lawrancekiamilev/FourChannelDiodebasedTemperatureMonitor/README.md

# FourChannelDiodebasedTemperatureMonitor
this project is a pcb and programing project. it is designed to be able to read the temperature of any diode based on its non ideal diode factor.  It is also designed to read an i2c EEPROM for serial identification and incorporates itself with a gui
