lawrancekiamilev/FourChannelDiodebasedTemperatureMonitor/PCBFiles/jlcProduction/jlcPCBTempMonitor3.0BOM.xlsx

Comment | Designator | FootPrint | JLCPCB PART#
TAXM12M4RKDCDT2T | Y1 | Crystal:Crystal_SMD_3225-4Pin_3.2x2.5mm | C403945
ADS1115IDGS | U14, U17 | Package_SO:TSSOP-10_3x3mm_P0.5mm | C37593
OPA348AIDCKR | U13, U15 | LawranceUserLib:OPAx348 | C363280
REF3320AIDBZR | U9, U10 | Package_TO_SOT_SMD:SOT-23 | C527421
TMUX1309PWR | U6 | Package_SO:TSSOP-16_4.4x5mm_P0.65mm | C2866286
W25Q16JVSS | U5 | Package_SO:SOIC-8_5.3x5.3mm_P1.27mm | C131025
AZ1117IH-3.3TRG1 | U4 | LawranceUserLib:AZ11171 | C108495
RP2040 | U3 | Package_DFN_QFN:QFN-56-1EP_7x7mm_P0.4mm_EP3.2x3.2mm_ThermalVias | C2040
TCA9548APWR | U2 | LawranceUserLib:TCA9548A | C130026
75R | R58, R59 | Resistor_SMD:R_0603_1608Metric | C25133
0R | R55, R65 | Resistor_SMD:R_0603_1608Metric | C21189
51k | R32 | Resistor_SMD:R_0603_1608Metric | C351642
5.1k | R31 | Resistor_SMD:R_0603_1608Metric | C122969
200k | R26 | Resistor_SMD:R_0603_1608Metric | C728585
2M | R25 | Resistor_SMD:R_0805_2012Metric | C2984387
10k | R6,R7,R8,R11,R12,R13,R14,R15,R20,R21,R23,R24,R27,R30,R35,R36,R47,R48,R56,R57,R60,R61,R62,R84,R85 | Resistor_SMD:R_0603_1608Metric | C25804
330R | R5, R17, R28, R29, R33 | Resistor_SMD:R_0603_1608Metric | C22775
1k | R3, R9 | Resistor_SMD:R_0603_1608Metric | C21190
27R | R1, R4 | Resistor_SMD:R_0603_1608Metric | C25190
SZ2012K272TF | FB1 | Resistor_SMD:R_0805_2012Metric | C185876
CN | D2,D3,D4,D5 | LED_SMD:LED_0603_1608Metric_Pad1.05x0.95mm_HandSolder | C165981
3.3V | D1 | LED_SMD:LED_0603_1608Metric_Pad1.05x0.95mm_HandSolder | C19171390
100nf | C27, C29, C30, C32, C34, C35, C39, C41, C42 | Capacitor_SMD:C_0603_1608Metric | C14663
1uf | C26, C37 | Capacitor_SMD:C_0603_1608Metric | C15849
6.8uF | C13 | Capacitor_SMD:C_0805_2012Metric | C15850
10uF | C10 | Capacitor_SMD:C_0805_2012Metric | C5139488
100nF | C9,C14 | Capacitor_SMD:C_0805_2012Metric | C49678
100nF | C7,C8,C11,C12,C16,C24,C33,C36,C38,C40,C43,C45 | Capacitor_SMD:C_0603_1608Metric | C14663
2.2uF | C5 | Capacitor_SMD:C_0805_2012Metric | C19110
3.3uF | C4 | Capacitor_SMD:C_0805_2012Metric | C7393948
4.7uF | C3, C6 | Capacitor_SMD:C_0805_2012Metric | C1779
33pF | C1, C2 | Capacitor_SMD:C_0603_1608Metric | C107047
