lawrancekiamilev/FourChannelDiodebasedTemperatureMonitor/PCBFiles/TempMonitorRev3.0.kicad_pcb

## KiCad design PCBFiles/TempMonitorRev3.0.kicad_pcb (2025-09-04)

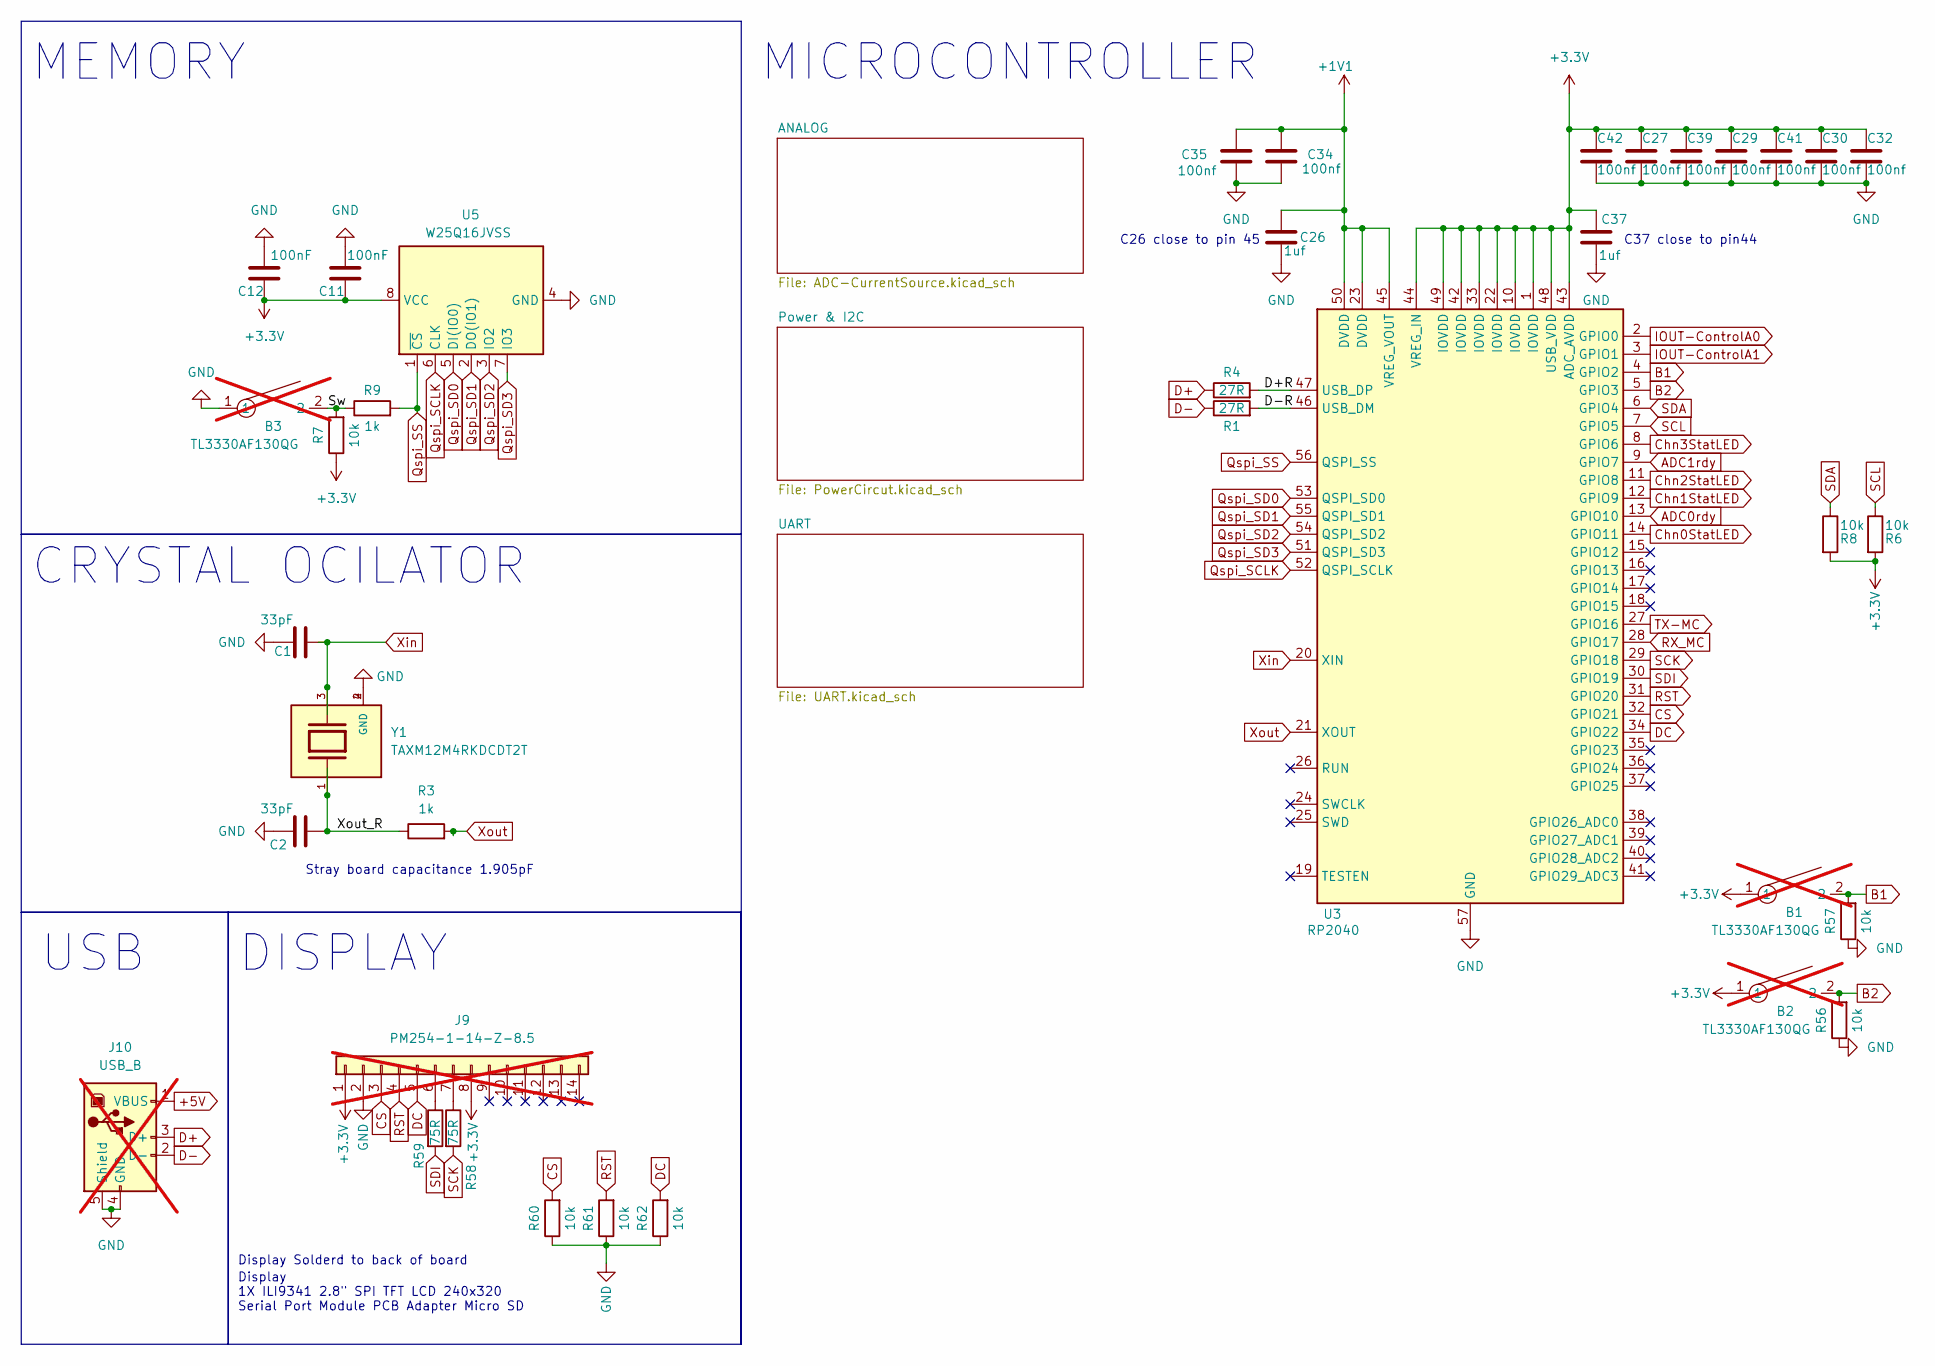
[picture p1: schematic TempMonitorRev3.0.kicad_sch, TempMonitorV3.0]

Parts:
B1, B2, B3: TL3330AF130QG; TL3330; JLC part # C2886885; not fitted
C1, C2: 33pF; C_0603_1608Metric; JLC part # C107047
C11, C12: 100nF; C_0603_1608Metric; JLC part # C14663
C26, C37: 1uf; C_0603_1608Metric; JLC part # C15849
C27, C29, C30, C32, C34, C35, C39, C41, C42: 100nf; C_0603_1608Metric; JLC part # C14663
J9: PM254-1-14-Z-8.5; PinSocket_1x14_P2.54mm_Vertical; JLC part # C2897377; not fitted
J10: USB_B; USB_B_OST_USB-B1HSxx_Horizontal; JLC part # C46392; not fitted
R1, R4: 27R; R_0603_1608Metric; JLC part # C25190
R3, R9: 1k; R_0603_1608Metric; JLC part # C21190
R6, R7, R8, R56, R57, R60, R61, R62: 10k; R_0603_1608Metric; JLC part # C25804
R58, R59: 75R; R_0603_1608Metric; JLC part # C25133
U3: RP2040; QFN-56-1EP_7x7mm_P0.4mm_EP3.2x3.2mm_ThermalVias; JLC part # C2040
U5: W25Q16JVSS; SOIC-8_5.3x5.3mm_P1.27mm; JLC part # C131025
Y1: TAXM12M4RKDCDT2T; Crystal_SMD_3225-4Pin_3.2x2.5mm; JLC part # C403945

Connections:
+1V1: C26.2, C34.1, C35.1, U3.23 (DVDD), U3.45 (VREG_VOUT), U3.50 (DVDD)
+3.3V: B1.1, B2.1, C11.1, C12.1, C27.1, C29.1, C30.1, C32.1, C37.2, C39.1, C41.1, C42.1, J9.1, J9.8, R6.2, R7.1, R8.2, U3.1 (IOVDD), U3.10 (IOVDD), U3.22 (IOVDD), U3.33 (IOVDD), U3.42 (IOVDD), U3.43 (ADC_AVDD), U3.44 (VREG_IN), U3.48 (USB_VDD), U3.49 (IOVDD), U5.8 (VCC); also elsewhere on the board
+5V: J10.1 (VBUS); also elsewhere on the board
/D+R: R4.2, U3.47 (USB_DP)
/D-R: R1.2, U3.46 (USB_DM)
/Sw: B3.2, R7.2, R9.1
/Xout_R: C2.1, R3.1, Y1.1
ADC0rdy: U3.13 (GPIO10); also elsewhere on the board
ADC1rdy: U3.9 (GPIO7); also elsewhere on the board
B1: B1.2, R57.2, U3.4 (GPIO2)
B2: B2.2, R56.2, U3.5 (GPIO3)
CS: J9.3, R60.2, U3.32 (GPIO21)
Chn0StatLED: U3.14 (GPIO11); also elsewhere on the board
Chn1StatLED: U3.12 (GPIO9); also elsewhere on the board
Chn2StatLED: U3.11 (GPIO8); also elsewhere on the board
Chn3StatLED: U3.8 (GPIO6); also elsewhere on the board
D+: J10.3 (D+), R4.1
D-: J10.2 (D-), R1.1
DC: J9.5, R62.2, U3.34 (GPIO22)
GND: B3.1, C1.2, C2.2, C11.2, C12.2, C26.1, C27.2, C29.2, C30.2, C32.2, C34.2, C35.2, C37.1, C39.2, C41.2, C42.2, J9.2, J10.4 (GND), J10.5 (Shield), R56.1, R57.1, R60.1, R61.1, R62.1, U3.57 (GND), U5.4 (GND), Y1.2 (GND), Y1.4 (GND); also elsewhere on the board
IOUT-ControlA0: U3.2 (GPIO0); also elsewhere on the board
IOUT-ControlA1: U3.3 (GPIO1); also elsewhere on the board
unnamed: J9.6, R59.1
unnamed: J9.7, R58.1
Qspi_SCLK: U3.52 (QSPI_SCLK), U5.6 (CLK)
Qspi_SD0: U3.53 (QSPI_SD0), U5.5 (DI(IO0))
Qspi_SD1: U3.55 (QSPI_SD1), U5.2 (DO(IO1))
Qspi_SD2: U3.54 (QSPI_SD2), U5.3 (IO2)
Qspi_SD3: U3.51 (QSPI_SD3), U5.7 (IO3)
Qspi_SS: R9.2, U3.56 (QSPI_SS), U5.1 (~CS)
RST: J9.4, R61.2, U3.31 (GPIO20)
RX_MC: U3.28 (GPIO17); also elsewhere on the board
SCK: R58.2, U3.29 (GPIO18)
SCL: R6.1, U3.7 (GPIO5); also elsewhere on the board
SDA: R8.1, U3.6 (GPIO4); also elsewhere on the board
SDI: R59.2, U3.30 (GPIO19)
TX-MC: U3.27 (GPIO16); also elsewhere on the board
Xin: C1.1, U3.20 (XIN), Y1.3
Xout: R3.2, U3.21 (XOUT)

Notes on the sheet:
C37 close to pin44
CRYSTAL OCILATOR
MICROCONTROLLER
Stray board capacitance 1.905pF
MEMORY
DISPLAY
Display 1X ILI9341 2.8" SPI TFT LCD 240x320 Serial Port Module PCB Adapter Micro SD
Display Solderd to back of board
USB
C26 close to pin 45

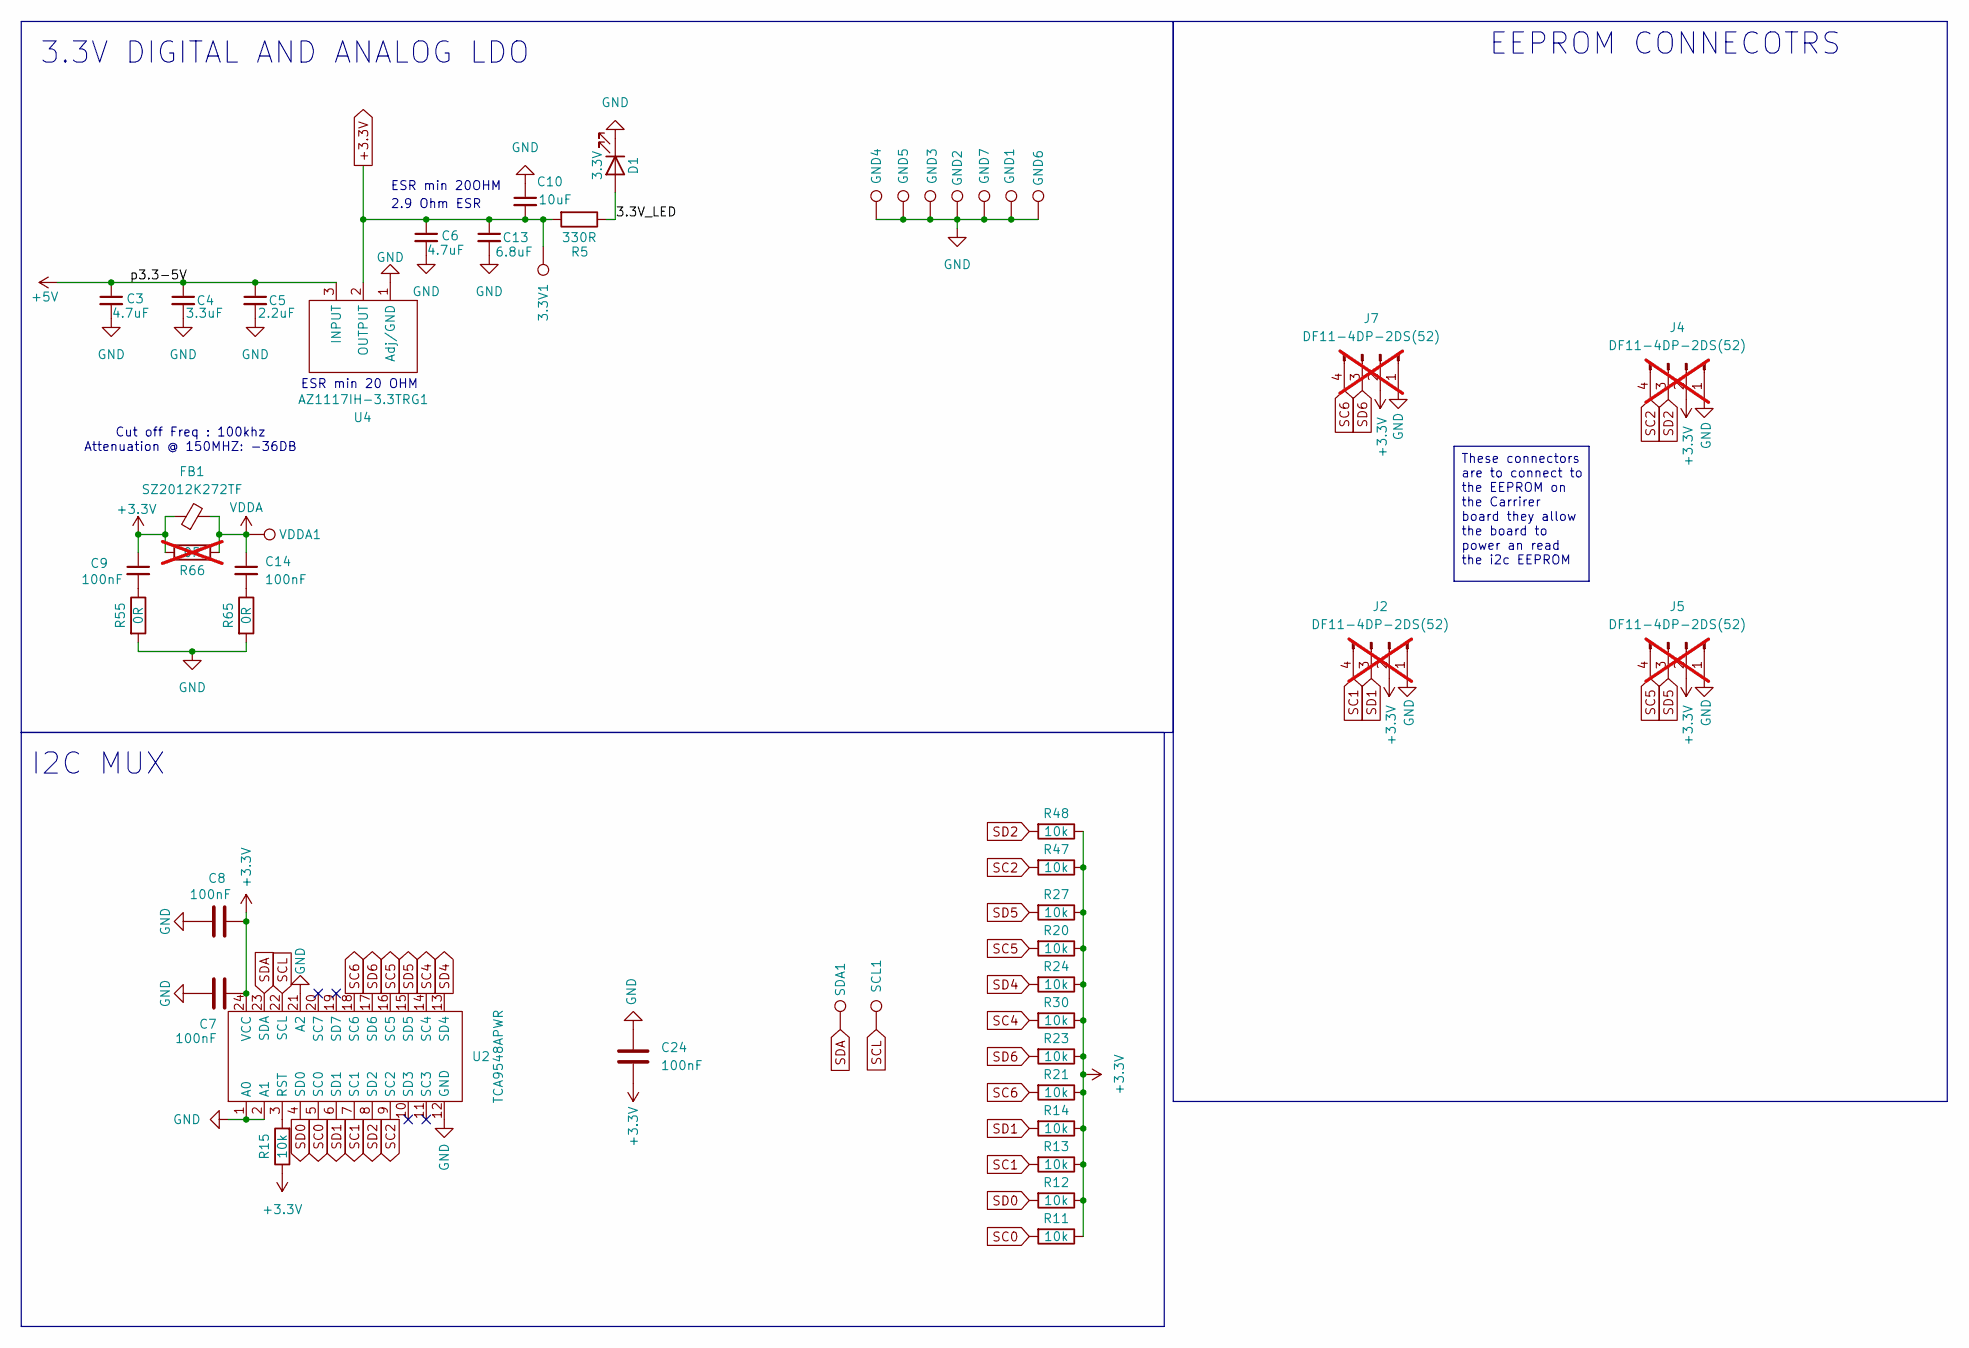
[picture p2: schematic PowerCircut.kicad_sch, TempMonitorV3.0]

Parts:
3.3V1: TestPoint; TestPoint_Pad_D1.5mm
C3, C6: 4.7uF; C_0805_2012Metric; JLC part # C1779
C4: 3.3uF; C_0805_2012Metric; JLC part # C7393948
C5: 2.2uF; C_0805_2012Metric; JLC part # C19110
C7, C8, C24: 100nF; C_0603_1608Metric; JLC part # C14663
C9, C14: 100nF; C_0805_2012Metric; JLC part # C49678
C10: 10uF; C_0805_2012Metric; JLC part # C5139488
C13: 6.8uF; C_0805_2012Metric; JLC part # C15850
D1: 3.3V; LED_0603_1608Metric_Pad1.05x0.95mm_HandSolder; JLC part # C19171390
FB1: SZ2012K272TF; R_0805_2012Metric; JLC part # C185876
GND1, GND2, GND3, GND4, GND5, GND6, GND7: TestPoint; TestPoint_Pad_D1.5mm
J2, J4, J5, J7: DF11-4DP-2DS(52); HRS_DF11-4DP-2DS_52_; not fitted
R5: 330R; R_0603_1608Metric; JLC part # C22775
R11, R12, R13, R14, R15, R20, R21, R23, R24, R27, R30, R47, R48: 10k; R_0603_1608Metric; JLC part # C25804
R55, R65: 0R; R_0603_1608Metric; JLC part # C21189
R66: 0R; R_0603_1608Metric; JLC part # C25804; not fitted
SCL1: TestPoint; TestPoint_Pad_D1.5mm
SDA1: TestPoint; TestPoint_Pad_D1.5mm
U2: TCA9548APWR; TCA9548A; JLC part # C130026
U4: AZ1117IH-3.3TRG1; AZ11171; JLC part # C108495
VDDA1: TestPoint; TestPoint_Pad_D1.5mm

Connections:
+3.3V: 3.3V1.1, C6.1, C7.2, C8.2, C9.1, C10.2, C13.1, C24.2, FB1.1, J2.2, J4.2, J5.2, J7.2, R5.2, R11.1, R12.1, R13.1, R14.1, R15.1, R20.1, R21.1, R23.1, R24.1, R27.1, R30.1, R47.1, R48.1, R66.1, U2.24 (VCC), U4.2 (OUTPUT); also elsewhere on the board
+5V: C3.1, C4.1, C5.1, U4.3 (INPUT); also elsewhere on the board
/Power & I2C/3.3V_LED: D1.2 (A), R5.1
GND: C3.2, C4.2, C5.2, C6.2, C7.1, C8.1, C10.1, C13.2, C24.1, D1.1 (K), GND1.1, GND2.1, GND3.1, GND4.1, GND5.1, GND6.1, GND7.1, J2.1, J4.1, J5.1, J7.1, R55.2, R65.2, U2.1 (A0), U2.2 (A1), U2.12 (GND), U2.21 (A2), U4.1 (Adj/GND); also elsewhere on the board
unnamed: C9.2, R55.1
unnamed: C14.2, R65.1
unnamed: R15.2, U2.3 (RST)
SC0: R11.2, U2.5 (SC0); also elsewhere on the board
SC1: J2.4, R13.2, U2.7 (SC1)
SC2: J4.4, R47.2, U2.9 (SC2)
SC4: R30.2, U2.14 (SC4); also elsewhere on the board
SC5: J5.4, R20.2, U2.16 (SC5)
SC6: J7.4, R21.2, U2.18 (SC6)
SCL: SCL1.1, U2.22 (SCL); also elsewhere on the board
SD0: R12.2, U2.4 (SD0); also elsewhere on the board
SD1: J2.3, R14.2, U2.6 (SD1)
SD2: J4.3, R48.2, U2.8 (SD2)
SD4: R24.2, U2.13 (SD4); also elsewhere on the board
SD5: J5.3, R27.2, U2.15 (SD5)
SD6: J7.3, R23.2, U2.17 (SD6)
SDA: SDA1.1, U2.23 (SDA); also elsewhere on the board
VDDA: C14.1, FB1.2, R66.2, VDDA1.1; also elsewhere on the board

Notes on the sheet:
Cut off Freq : 100khz Attenuation @ 150MHZ: -36DB
I2C MUX
3.3V DIGITAL AND ANALOG LDO
ESR min 20 OHM
2.9 Ohm ESR
EEPROM CONNECOTRS
ESR min 20OHM
These connectors are to connect to the EEPROM on the Carrirer board they allow the board to power an read the i2c EEPROM

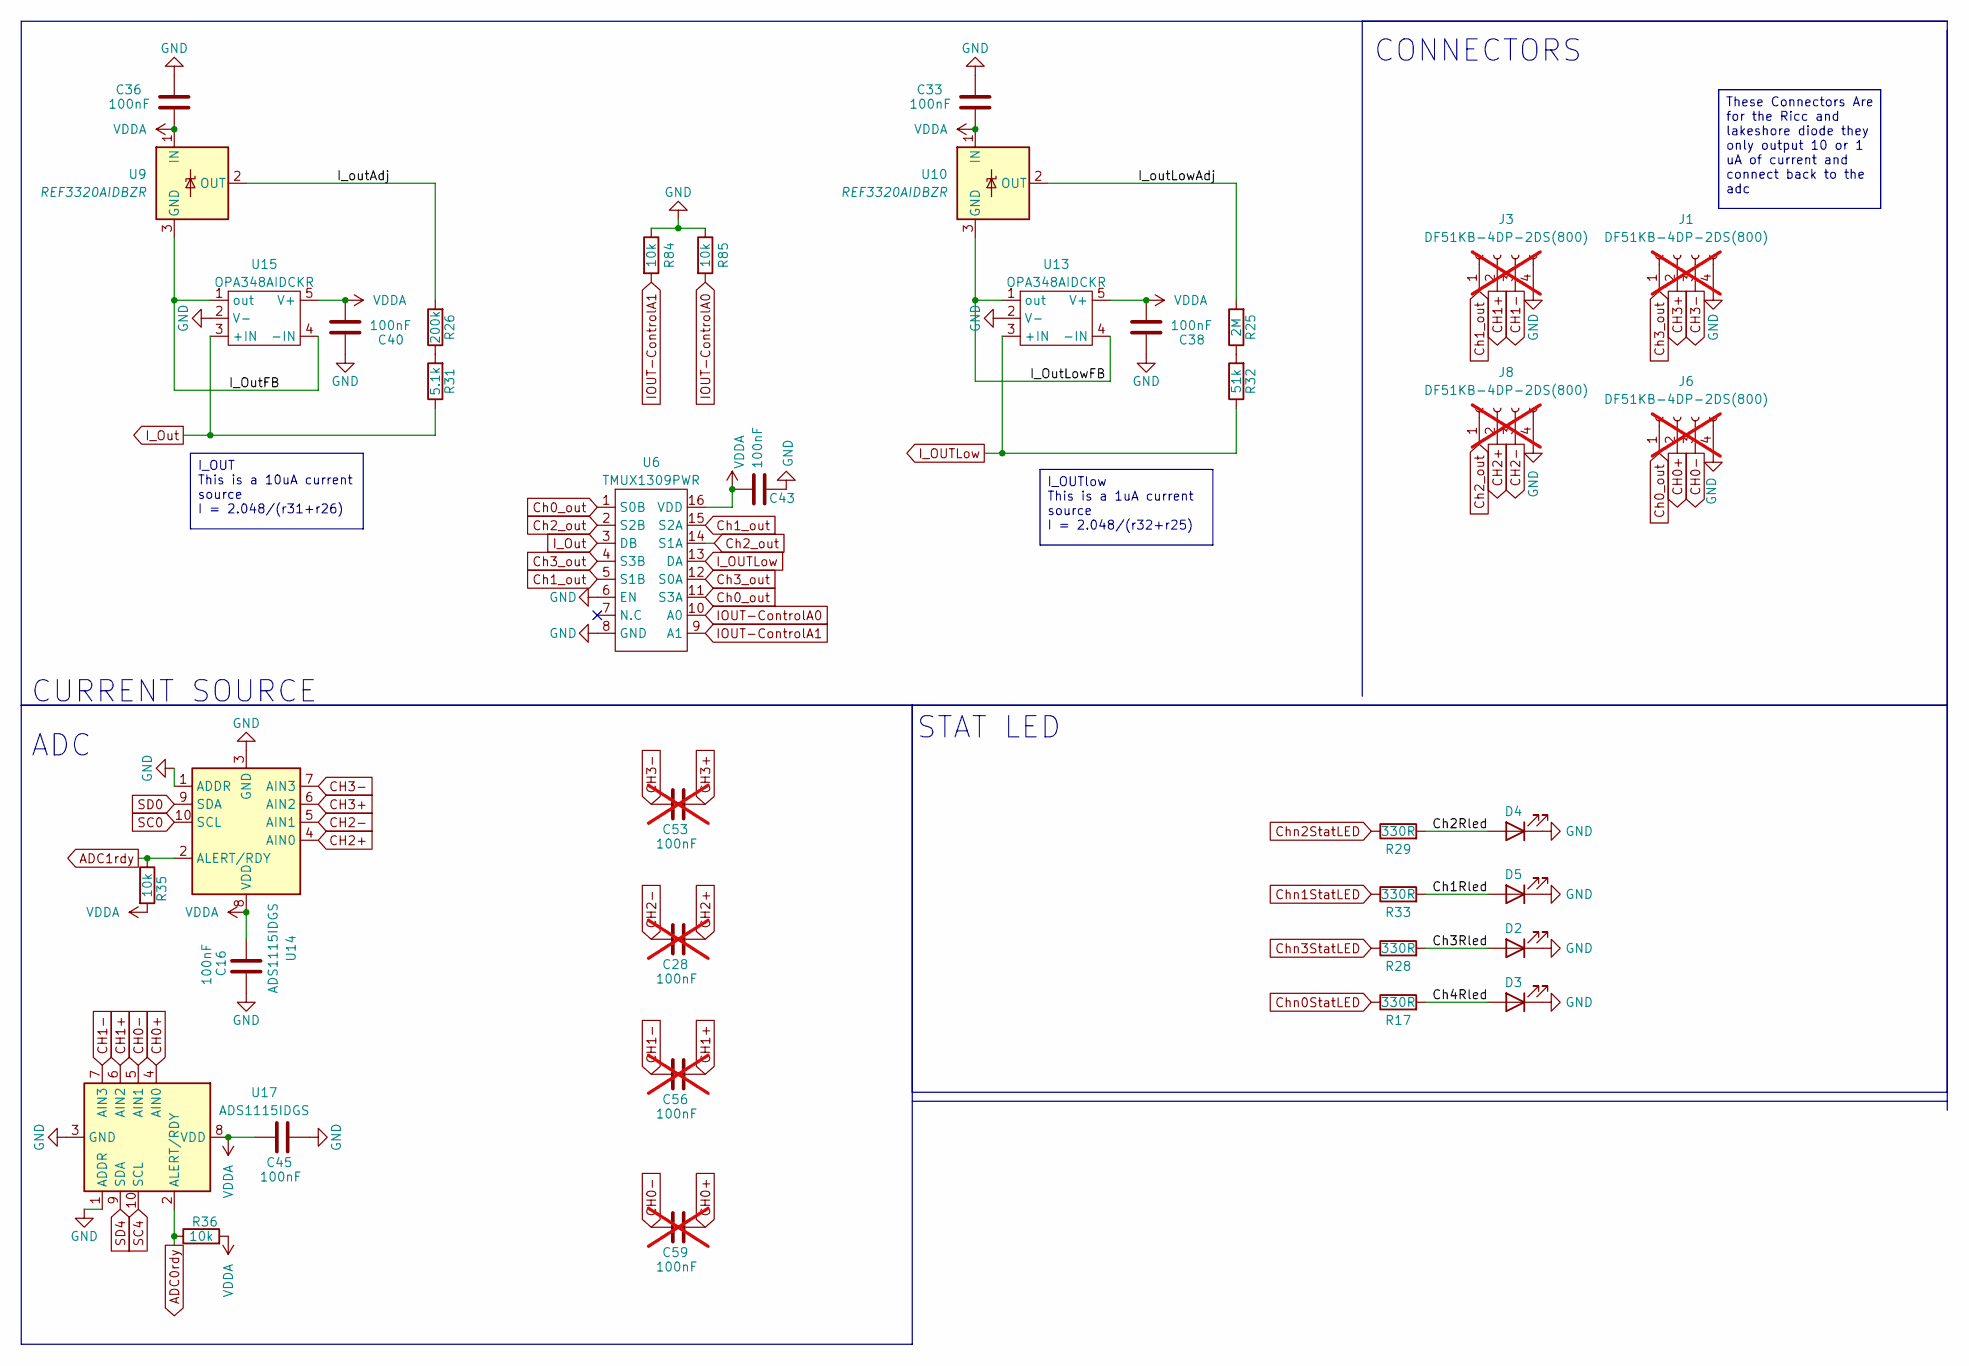
[picture p3: schematic ADC-CurrentSource.kicad_sch, TempMonitorV3.0]

Parts:
C16, C33, C36, C38, C40, C43, C45: 100nF; C_0603_1608Metric; JLC part # C14663
C28, C53, C56, C59: 100nF; C_0603_1608Metric; JLC part # C14663; not fitted
D2, D3, D4, D5: CN; LED_0603_1608Metric_Pad1.05x0.95mm_HandSolder; JLC part # C165981
J1, J3, J6, J8: DF51KB-4DP-2DS(800); DF51K-4DS-2C(800); not fitted
R17, R28, R29, R33: 330R; R_0603_1608Metric; JLC part # C22775
R25: 2M; R_0805_2012Metric; JLC part # C2984387
R26: 200k; R_0603_1608Metric; JLC part # C728585
R31: 5.1k; R_0603_1608Metric; JLC part # C122969
R32: 51k; R_0603_1608Metric; JLC part # C351642
R35, R36, R84, R85: 10k; R_0603_1608Metric; JLC part # C25804
U6: TMUX1309PWR; TSSOP-16_4.4x5mm_P0.65mm; JLC part # C2866286
U9, U10: REF3320AIDBZR; SOT-23; JLC part # C527421
U13, U15: OPA348AIDCKR; OPAx348; JLC part # C363280
U14, U17: ADS1115IDGS; TSSOP-10_3x3mm_P0.5mm; JLC part # C37593

Connections:
/ANALOG/Ch1Rled: D5.2 (A), R33.2
/ANALOG/Ch2Rled: D4.2 (A), R29.2
/ANALOG/Ch3Rled: D2.2 (A), R28.2
/ANALOG/Ch4Rled: D3.2 (A), R17.2
/ANALOG/I_OutFB: U9.3 (GND), U15.1 (out), U15.4 (-IN)
/ANALOG/I_OutLowFB: U10.3 (GND), U13.1 (out), U13.4 (-IN)
/ANALOG/I_outAdj: R26.2, U9.2 (OUT)
/ANALOG/I_outLowAdj: R25.2, U10.2 (OUT)
ADC0rdy: R36.1, U17.2 (ALERT/RDY); also elsewhere on the board
ADC1rdy: R35.1, U14.2 (ALERT/RDY); also elsewhere on the board
CH0+: C59.2, J6.2, U17.4 (AIN0)
CH0-: C59.1, J6.3, U17.5 (AIN1)
CH1+: C56.2, J3.2, U17.6 (AIN2)
CH1-: C56.1, J3.3, U17.7 (AIN3)
CH2+: C28.2, J8.2, U14.4 (AIN0)
CH2-: C28.1, J8.3, U14.5 (AIN1)
CH3+: C53.2, J1.2, U14.6 (AIN2)
CH3-: C53.1, J1.3, U14.7 (AIN3)
Ch0_out: J6.1, U6.1 (S0B), U6.11 (S3A)
Ch1_out: J3.1, U6.5 (S1B), U6.15 (S2A)
Ch2_out: J8.1, U6.2 (S2B), U6.14 (S1A)
Ch3_out: J1.1, U6.4 (S3B), U6.12 (S0A)
Chn0StatLED: R17.1; also elsewhere on the board
Chn1StatLED: R33.1; also elsewhere on the board
Chn2StatLED: R29.1; also elsewhere on the board
Chn3StatLED: R28.1; also elsewhere on the board
GND: C16.2, C33.1, C36.1, C38.1, C40.1, C43.1, C45.2, D2.1 (K), D3.1 (K), D4.1 (K), D5.1 (K), J1.4, J3.4, J6.4, J8.4, R84.1, R85.1, U6.6 (EN), U6.8 (GND), U13.2 (V-), U14.1 (ADDR), U14.3 (GND), U15.2 (V-), U17.1 (ADDR), U17.3 (GND); also elsewhere on the board
IOUT-ControlA0: R85.2, U6.10 (A0); also elsewhere on the board
IOUT-ControlA1: R84.2, U6.9 (A1); also elsewhere on the board
I_OUTLow: R32.1, U6.13 (DA), U13.3 (+IN)
I_Out: R31.1, U6.3 (DB), U15.3 (+IN)
unnamed: R25.1, R32.2
unnamed: R26.1, R31.2
SC0: U14.10 (SCL); also elsewhere on the board
SC4: U17.10 (SCL); also elsewhere on the board
SD0: U14.9 (SDA); also elsewhere on the board
SD4: U17.9 (SDA); also elsewhere on the board
VDDA: C16.1, C33.2, C36.2, C38.2, C40.2, C43.2, C45.1, R35.2, R36.2, U6.16 (VDD), U9.1 (IN), U10.1 (IN), U13.5 (V+), U14.8 (VDD), U15.5 (V+), U17.8 (VDD); also elsewhere on the board

Notes on the sheet:
CONNECTORS
ADC
STAT LED
CURRENT SOURCE
These Connectors Are for the Ricc and lakeshore diode they only output 10 or 1 uA of current and connect back to the adc
I_OUT This is a 10uA current source I = 2.048/(r31+r26)
I_OUTlow This is a 1uA current source I = 2.048/(r32+r25)

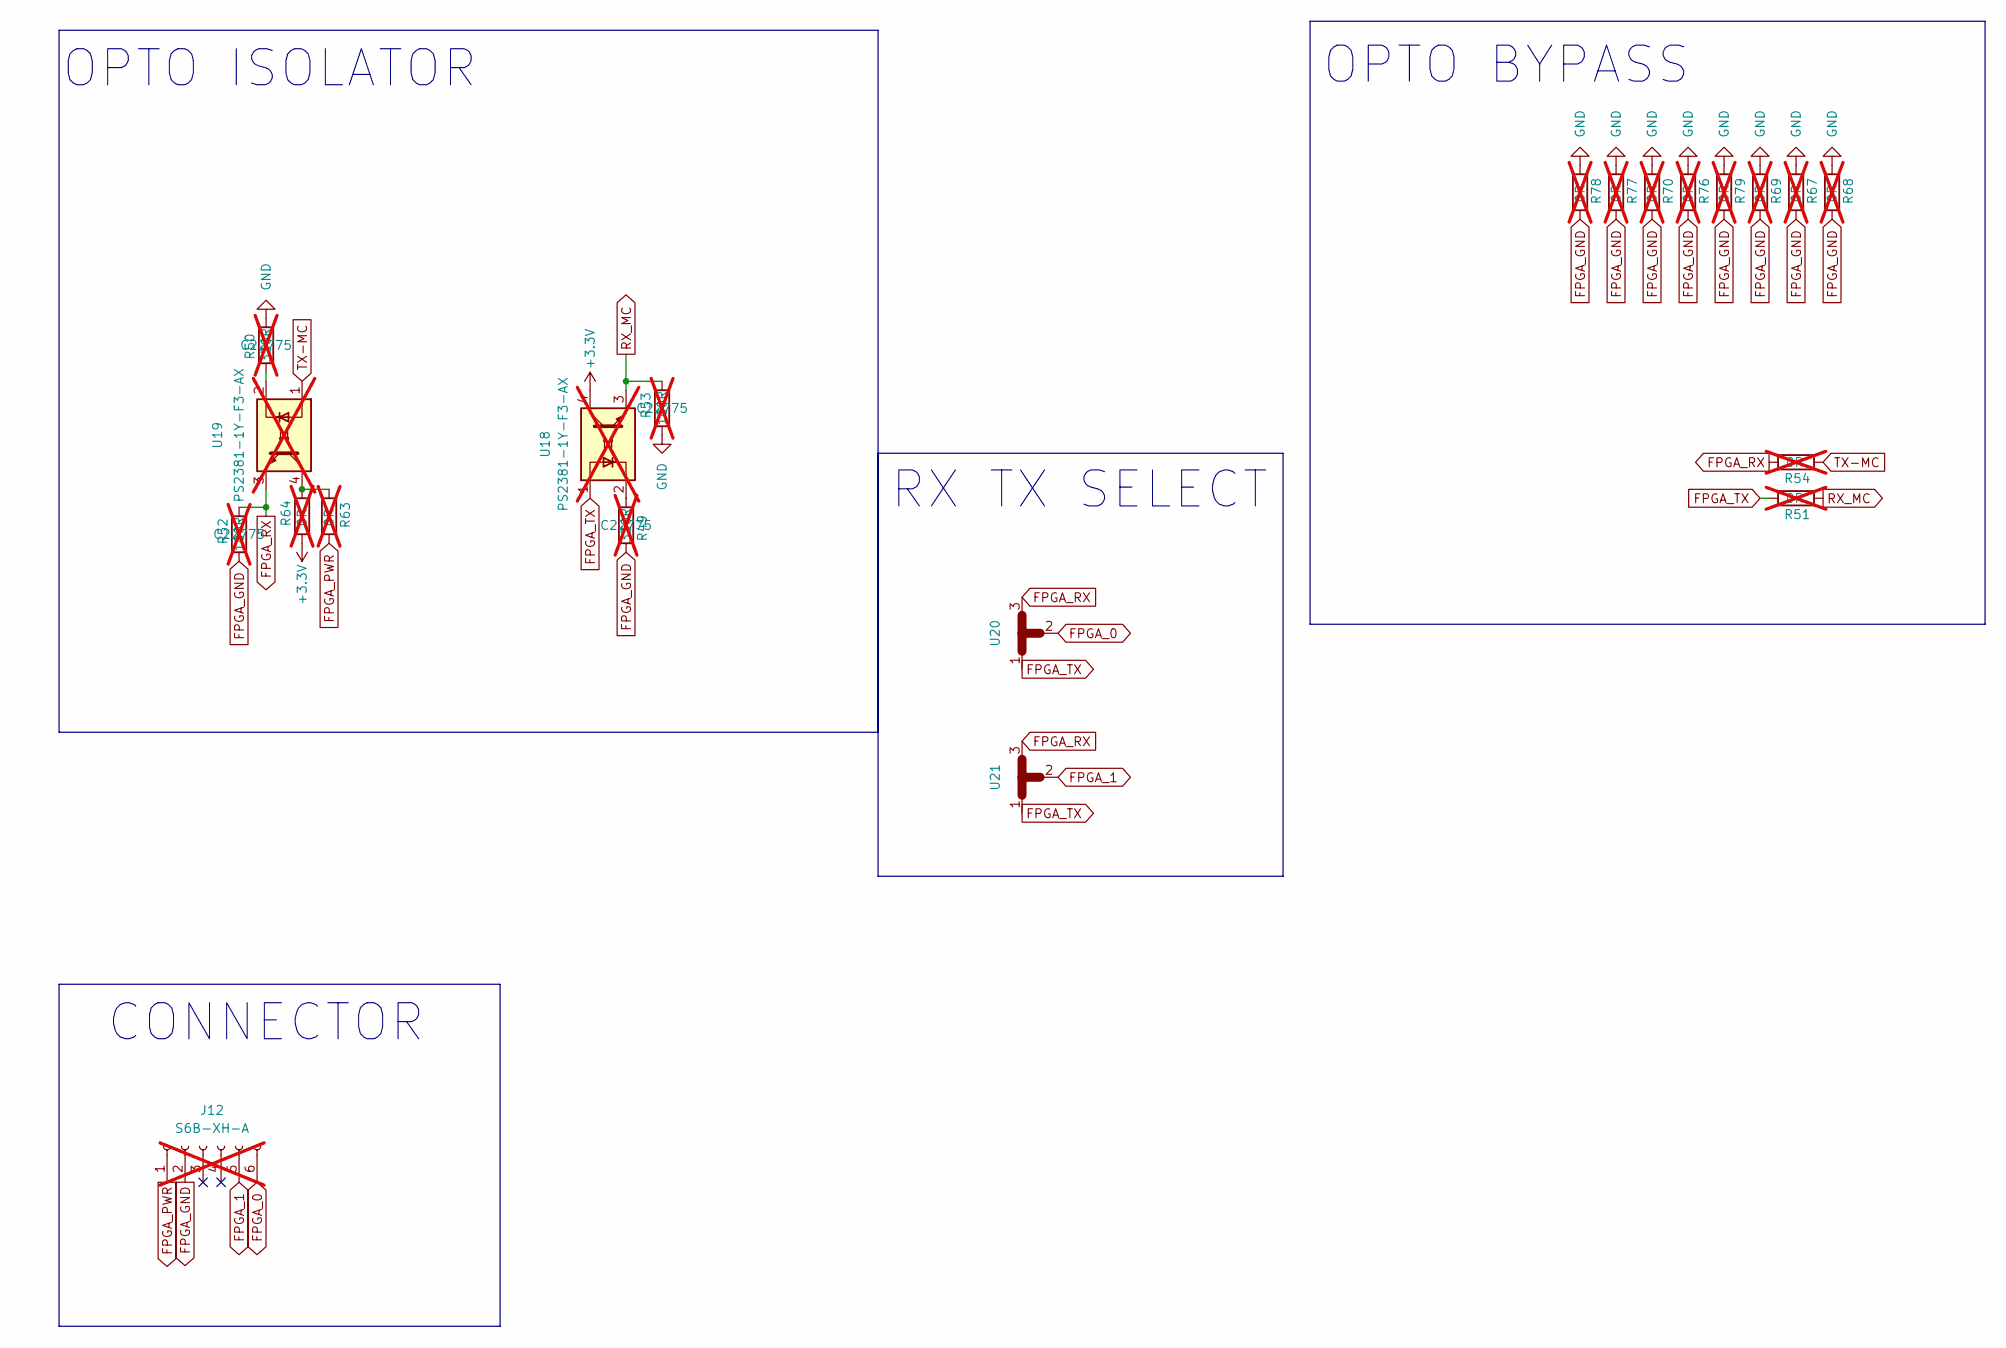
[picture p4: schematic UART.kicad_sch, TempMonitorV3.0]

Parts:
J12: S6B-XH-A; JST_EH_S6B-EH_1x06_P2.50mm_Horizontal; not fitted
R49, R50: 330R; R_0603_1608Metric; JLC part # C22775; not fitted
R51, R54, R67, R68, R69, R70, R76, R77, R78, R79: 0R; R_0805_2012Metric_Pad1.20x1.40mm_HandSolder; not fitted
R52, R53: 100R; R_0603_1608Metric; JLC part # C22775; not fitted
R63, R64: 0R; R_0603_1608Metric; not fitted
U18, U19: PS2381-1Y-F3-AX; LSOP-4 (2.54mm); not fitted
U20, U21: SolderJumper-3_P1.3mm_Open_RoundedPad1.0x1.5mm_NumberLabels

Connections:
+3.3V: R64.2, U18.4; also elsewhere on the board
FPGA_0: J12.6, U20.2
FPGA_1: J12.5, U21.2
FPGA_GND: J12.2, R49.1, R52.2, R67.2, R68.2, R69.2, R70.2, R76.2, R77.2, R78.2, R79.2
FPGA_PWR: J12.1, R63.2
FPGA_RX: R52.1, R54.2, U19.3, U20.3, U21.3
FPGA_TX: R51.2, U18.1, U20.1, U21.1
GND: R50.2, R53.2, R67.1, R68.1, R69.1, R70.1, R76.1, R77.1, R78.1, R79.1; also elsewhere on the board
unnamed: R49.2, U18.2
unnamed: R50.1, U19.2
unnamed: R63.1, R64.1, U19.4
RX_MC: R51.1, R53.1, U18.3; also elsewhere on the board
TX-MC: R54.1, U19.1; also elsewhere on the board

Notes on the sheet:
RX TX SELECT
OPTO BYPASS
CONNECTOR
OPTO ISOLATOR

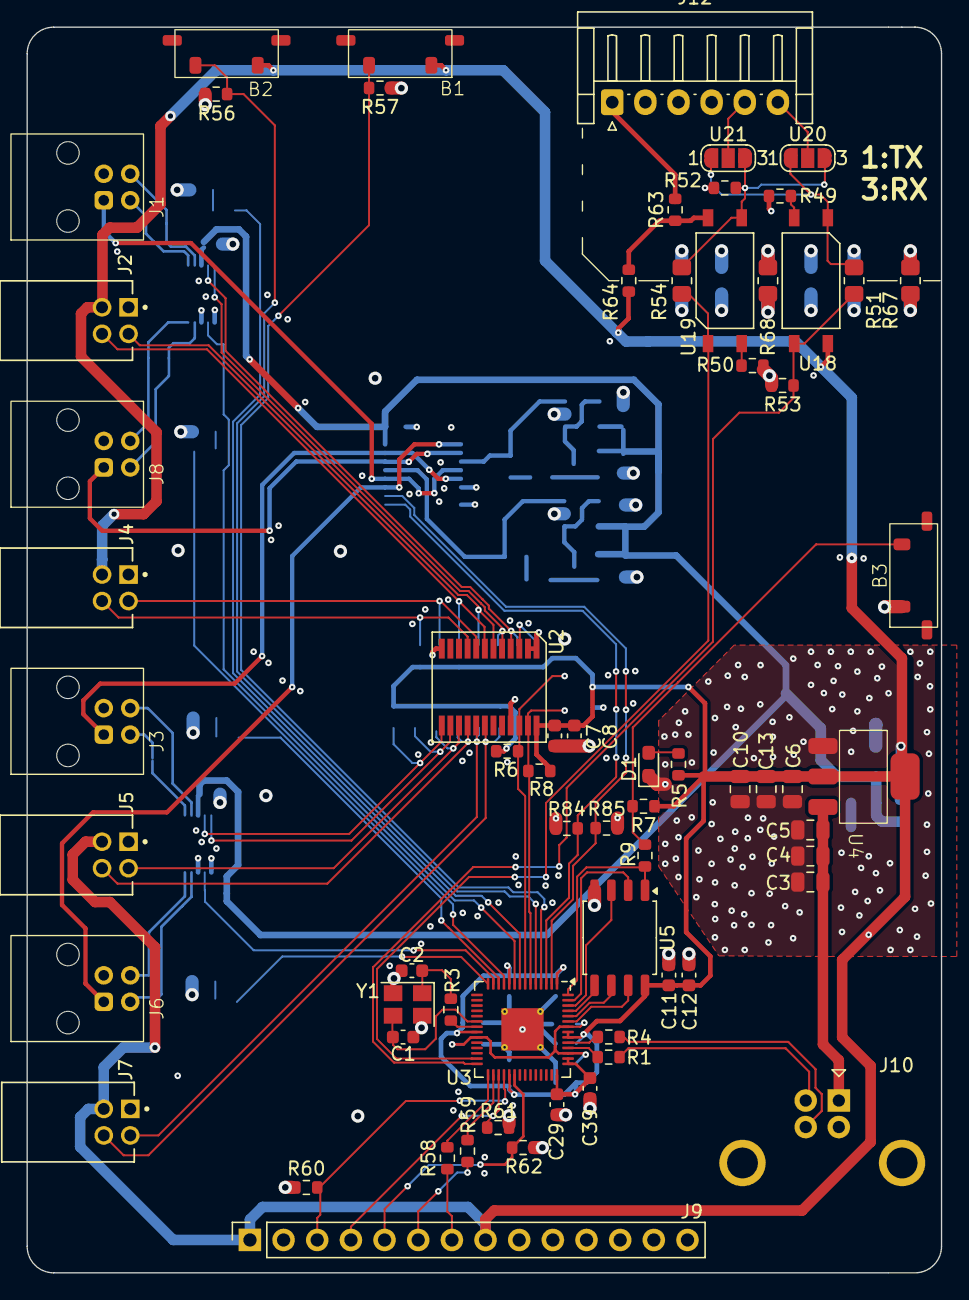
[picture p5: board TempMonitorRev3.0.kicad_pcb from above]

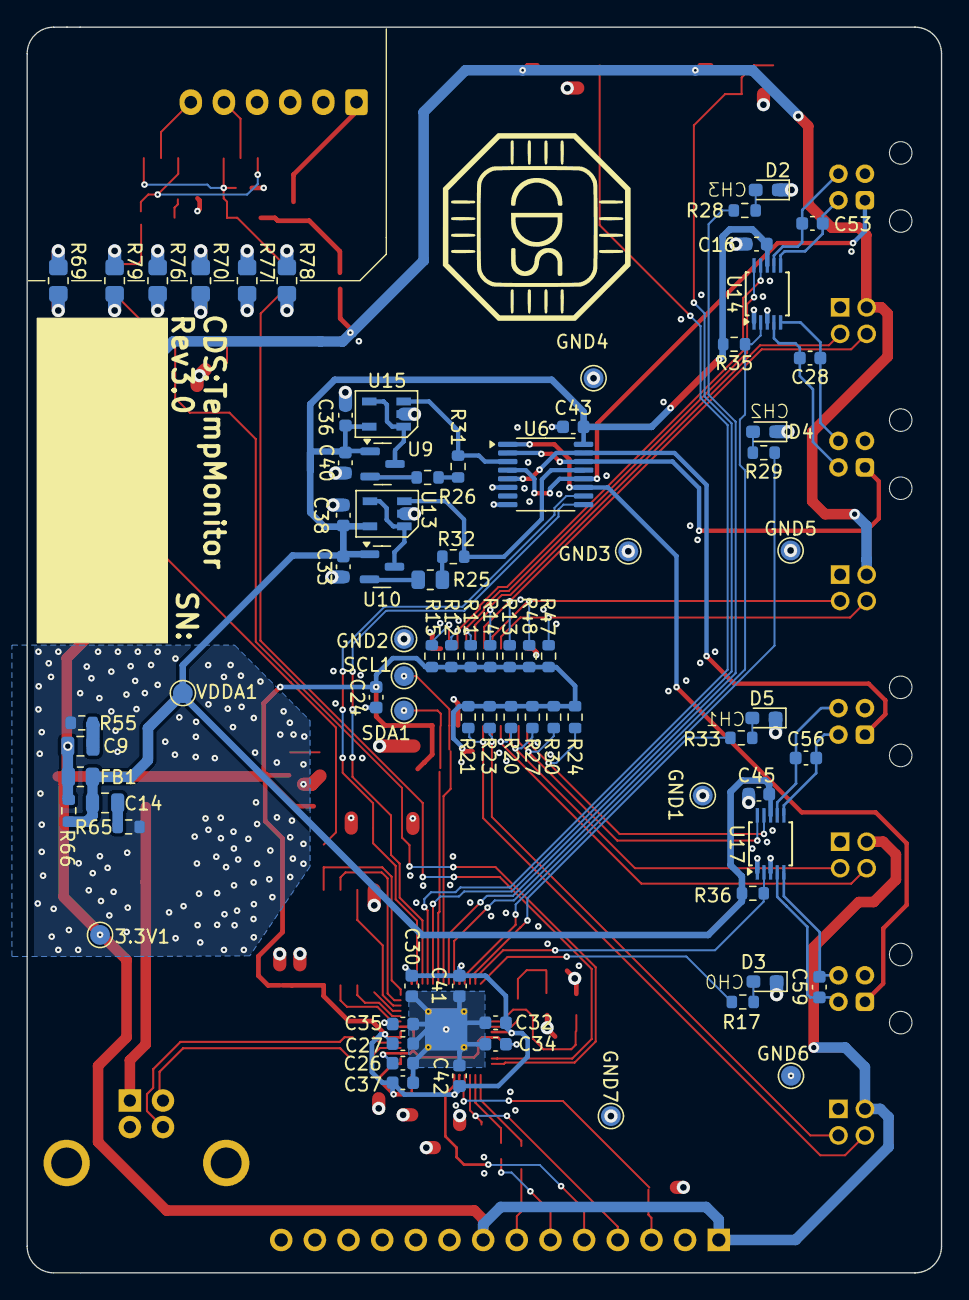
[picture p6: board TempMonitorRev3.0.kicad_pcb from below]

Board: 4 copper layers, 69.0 x 94.0 mm, 143 parts (78 on the bottom side), 89 nets.
