lawrancekiamilev/FourChannelDiodebasedTemperatureMonitor/tempmonitorfirmware/cdsLogo.c

#include "PinDeff.h"
#include "ili9341.h"
uint8_t cdsLogoSmall[] = {
	0x00, 0x03, 0xff, 0xff, 0xf0, 0x00, 0x00, 0x00, 0x07, 0xff, 0xff, 0xf8, 0x00, 0x00, 0x00, 0x0c,
	0x22, 0x11, 0x0c, 0x00, 0x00, 0x00, 0x18, 0x22, 0x11, 0x06, 0x00, 0x00, 0x00, 0x30, 0x22, 0x11,
	0x03, 0x00, 0x00, 0x00, 0x60, 0x22, 0x11, 0x01, 0x80, 0x00, 0x00, 0xc0, 0x22, 0x11, 0x00, 0xc0,
	0x00, 0x01, 0x80, 0x22, 0x11, 0x00, 0x60, 0x00, 0x03, 0x00, 0x22, 0x11, 0x00, 0x30, 0x00, 0x06,
	0x0f, 0xff, 0xff, 0xfc, 0x18, 0x00, 0x0c, 0x30, 0x00, 0x00, 0x06, 0x0c, 0x00, 0x18, 0x20, 0x00,
	0x00, 0x01, 0x06, 0x00, 0x30, 0x40, 0x00, 0x00, 0x01, 0x83, 0x00, 0x60, 0x40, 0x00, 0x00, 0x00,
	0x81, 0x80, 0xc0, 0x40, 0x00, 0x00, 0x00, 0x80, 0xc0, 0xc0, 0x40, 0x00, 0x00, 0x00, 0x80, 0xc0,
	0xc0, 0x40, 0x00, 0x00, 0x00, 0x80, 0xc0, 0xc0, 0x40, 0x00, 0x00, 0x00, 0x80, 0xc0, 0xff, 0xc0,
	0xe7, 0xc0, 0x7c, 0xbf, 0xc0, 0xc0, 0x43, 0xc7, 0xf1, 0xf8, 0x80, 0xc0, 0xc0, 0x47, 0x06, 0x39,
	0x00, 0x80, 0xc0, 0xc0, 0x46, 0x06, 0x09, 0x00, 0x80, 0xc0, 0xff, 0xcc, 0x06, 0x0f, 0x00, 0xbf,
	0xc0, 0xc0, 0x4c, 0x06, 0x05, 0x80, 0x80, 0xc0, 0xc0, 0x48, 0x06, 0x04, 0xf0, 0x80, 0xc0, 0xc0,
	0x48, 0x06, 0x04, 0x78, 0x80, 0xc0, 0xde, 0xcc, 0x06, 0x04, 0x0c, 0xbe, 0xc0, 0xc0, 0x4c, 0x06,
	0x0c, 0x04, 0x90, 0xc0, 0xc0, 0x46, 0x06, 0x08, 0x04, 0x80, 0xc0, 0xc0, 0x47, 0x06, 0x38, 0x0c,
	0x80, 0xc0, 0xc0, 0x41, 0xe6, 0xf0, 0x38, 0x80, 0xc0, 0xff, 0xc0, 0xff, 0xc1, 0xf0, 0xbf, 0xc0,
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
	0x00, 0x00, 0x00, 0x00, 0x00, 0x00, 0x00, 0x00, 0x00, 0x00, 0x00, 0x00, 0x00, 0x00, 0x00, 0x00,
	0x00, 0x00, 0x00, 0x00, 0x00, 0x00, 0x03, 0xfc, 0x00, 0x00, 0x00, 0x00, 0x00, 0x00, 0x00, 0x00,
	0xff, 0x00, 0x00, 0x00, 0x00, 0x00, 0x00, 0x00, 0x00, 0x00, 0x00, 0x00, 0x00, 0x00, 0x00, 0x00,
	0x00, 0x00, 0x00, 0x00, 0x00, 0x00, 0x00, 0x00, 0x00, 0x00, 0x00, 0x00, 0x00, 0x00, 0x07, 0xf8,
	0x00, 0x80, 0x01, 0x00, 0x02, 0x00, 0x0c, 0x00, 0x7f, 0x80, 0x00, 0x00, 0x00, 0x00, 0x00, 0x00,
	0x00, 0x00, 0x00, 0x00, 0x00, 0x00, 0x00, 0x00, 0x00, 0x00, 0x00, 0x00, 0x00, 0x00, 0x00, 0x00,
	0x00, 0x00, 0x00, 0x00, 0x00, 0x00, 0x0f, 0xf0, 0x01, 0xc0, 0x03, 0x80, 0x07, 0x00, 0x1c, 0x00,
	0x3f, 0xc0, 0x00, 0x00, 0x00, 0x00, 0x00, 0x00, 0x00, 0x00, 0x00, 0x00, 0x00, 0x00, 0x00, 0x00,
	0x00, 0x00, 0x00, 0x00, 0x00, 0x00, 0x00, 0x00, 0x00, 0x00, 0x00, 0x00, 0x00, 0x00, 0x1f, 0xe0,
	0x01, 0xc0, 0x03, 0x80, 0x07, 0x00, 0x1e, 0x00, 0x1f, 0xe0, 0x00, 0x00, 0x00, 0x00, 0x00, 0x00,
	0x00, 0x00, 0x00, 0x00, 0x00, 0x00, 0x00, 0x00, 0x00, 0x00, 0x00, 0x00, 0x00, 0x00, 0x00, 0x00,
	0x00, 0x00, 0x00, 0x00, 0x00, 0x00, 0x3f, 0xc0, 0x01, 0xc0, 0x03, 0x80, 0x07, 0x00, 0x1c, 0x00,
	0x0f, 0xf0, 0x00, 0x00, 0x00, 0x00, 0x00, 0x00, 0x00, 0x00, 0x00, 0x00, 0x00, 0x00, 0x00, 0x00,
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
